Yadukrishnan-KM/Auto_Water_Pump_1HP/Modified Tx unit version using new sensor/Program/AutoWaterPump_Tx_Unit_without_UART_samecode/Microcontroller settings.txt

minicore library(board library)
atmega328p
internal 8 mhz

upload code using ISP method (I used USB ASP Programmer specially for ATMEL), UART not preffered. If crystall is not working then it will fail.
in ISP with or without crystal everything will work.

last update : 16/07/2024
Author : Yadukrishnan K M
