Yadukrishnan-KM/Auto_Water_Pump_1HP/Hardware/Power Circuit/Power Circuit Design report.docx

AC Current Consumption

@228V AC

Idle Condition - 283mA

Relay ON Condition - 372mA
