Yadukrishnan-KM/Auto_Water_Pump_1HP/Hardware/Transmitter/Sensor Unit Design report.docx

Current Measurements of Sensor PCB

@5V

Startup - 13.6mA

Sensor Reading - 16.1mA

Tx active - 15.2mA

Sleep - 4.7mA
