Yadukrishnan-KM/Auto_Water_Pump_1HP/Auto Pump Stickers/front sticker final wrong dimension.png

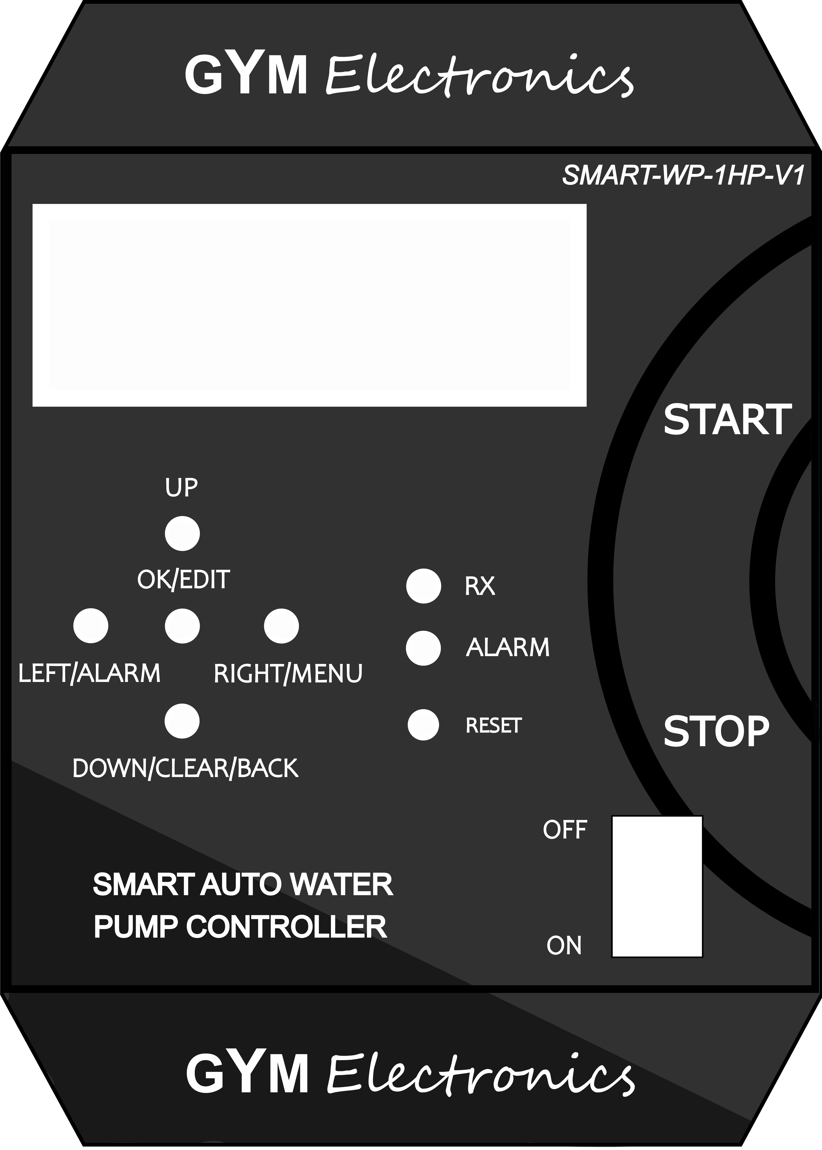
Auto Pump Stickers/front sticker final wrong dimension.png
