Yadukrishnan-KM/Auto_Water_Pump_1HP/Hardware/Datasheet/ATmega328p.png

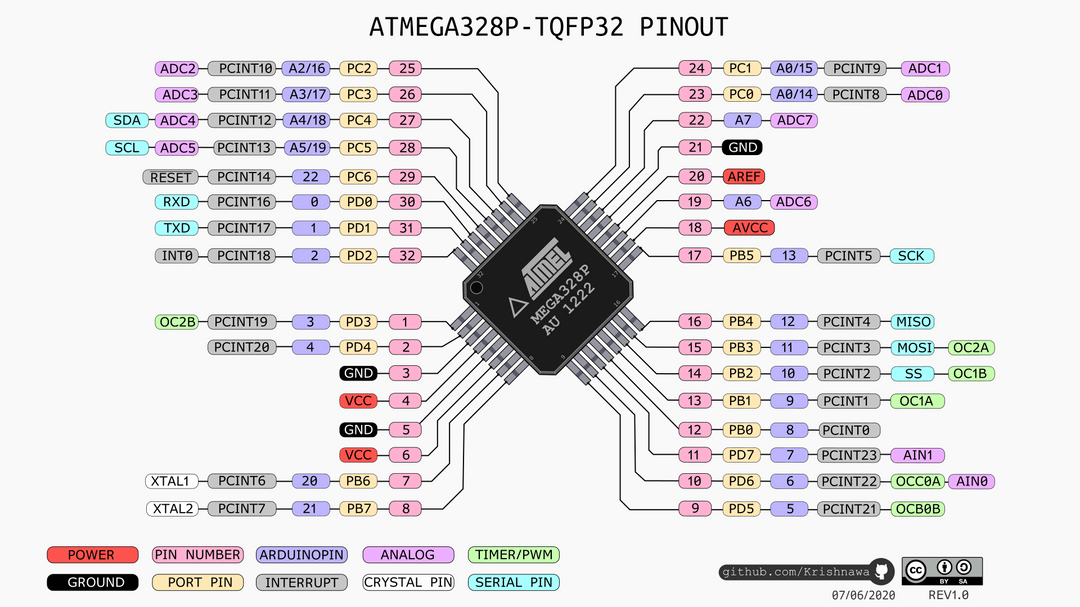
Hardware/Datasheet/ATmega328p.png
