Yadukrishnan-KM/Auto_Water_Pump_1HP/Hardware/Full BOM.xls

Main Controller |  |  |  | Powersupply |  |  |  | Transmitter
ID | Name | Footprint | Quantity | ID | Name | Footprint | Quantity | ID | Name | Footprint | Quantity
Capacitors |  |  |  | Resistors |  |  |  | Capacitors
1 | 100uF | TH CAP-D6.3XF2.5 | 1 | 1 | 435K | R0603 | 1 | 1 | 10uF | C1206 | 4
2 | 10uF | C1206 | 2 | 2 | 220K | R0603 | 3 | 2 | 10uF | C0603 | 2
3 | 10uF | C0805 | 2 | 3 | 100K | R1206 | 2 | 3 | 1uF | C1206 | 1
4 | 0.1uF | C0603 | 9 | 4 | 100K | R0603 | 2 | 4 | 0.1uF | C0603 | 8
5 | 1nF | C0603 | 1 | 5 | 57K | R0603 | 1 | 5 | 1nF | C0603 | 2
6 | 22pF | C0603 | 2 | 6 | 47K | R0603 | 2 | 6 | 10pF | C0603 | 2
Resistors |  |  |  | 7 | 10K | R0603 | 4 | Resistors
1 | 100K | R0603 | 6 | 8 | 3K3 | R0603 | 2 | 1 | 1M | R0603 | 1
2 | 12K | R0603 | 5 | 9 | 3k | R0603 | 1 | 2 | 100K | R0603 | 2
3 | 10K | R0603 | 6 | 10 | 2K2 | R0603 | 3 | 3 | 10K | R0603 | 16
4 | 4.7K | R0603 | 1 | 11 | 1K2 | R0603 | 1 | 4 | 1K | R0603 | 3
5 | 3K3 | R0603 | 1 | 12 | 1k | R0603 | 3 | 5 | 330E | R0603 | 2
6 | 2K | R0603 | 1 | 13 | 220E | R0603 | 1 | Diodes
7 | 1k | R0603 | 7 | 14 | 22E | R1206 | 1 | 1 | SMBJ6.5 | SMB_L4.6-W3.6-LS5.3-BI | 1
8 | 620E | R0603 | 1 | 15 | 1E | R0805 | 3 | 2 | 7V5 | SOD-80_L3.5-W1.5-RD | 1
9 | 330E | R0603 | 1 | 16 | 0E | R1206 | 1 | 3 | LED_SMD | LED0603_RED | 4
10 | 100E | R0603 | 1 | 17 | 0E | R0805 | 4 | Transistors
Transistors |  |  |  | 18 | 1M | R_TH_AXIAL-0.4 | 1 | 1 | 2222A | SOT-23-3 | 7
1 | J3Y | SOT-23-3 | 1 | 19 | 680K | R_TH_AXIAL-0.4 | 1 | 2 | A1SHB | SOT-23 | 2
2 | 2N3904 | SOT-23-3 | 1 | 20 | 1K | R_TH_AXIAL-0.4 | 1 | ICs
3 | 2222A | SOT-23-3 | 5 | 21 | 390E | R_TH_AXIAL-0.3 | 1 | 1 | ATmega328P | TQFP-32 | 1
Diodes |  |  |  | 22 | 220E | TH_RESISTOR_VERTICAL | 1 | 2 | TP4055 | SOT-23-5 | 1
1 | SMBJ6.5C(TVS Diode) | SMB_L4.6-W3.6-LS5.3-BI | 1 | 23 | 120E | R_TH_AXIAL-0.3 | 2 | 3 | HT12E | SOIC20 | 1
2 | LED | LED-TH_BD3.0_BLUE | 2 | 24 | 100E/1W | R_TH_AXIAL-0.5 | 1 | Others
IC's |  |  |  | 25 | 30E | R_TH_AXIAL-0.4 | 1 | 1 | Push Switch SMD | SW-SMD_4P-L5.2-W5.2-P3.70-LS6.4 | 2
1 | ATMEGA328P | TQFP-32 | 1 | 26 | 40000000 | TH_RESISTOR_VERTICAL | 2 | 2 | DIP Switch 8 Pole | SW-TH_1825057-7 | 1
2 | PCF8574T | SOP-16 | 1 | Capacitors |  |  |  | 3 | RF433MHZ Transmitter | RF433MHZ TRANSMITTER MODULE | 1
3 | HT12D | DIP-18 | 1 | 1 | 1000uF | CAP-D8.0×F3.5 | 2 | 4 | 16MHz | SMD 3213 | 1
Others |  |  |  | 2 | 220uF | CAP-D6.3×F2.5 | 2
1 | PushButton | SW-TH_4PIN-L6.00-W6.00 | 6 | 3 | 100uF | CAP-D6.3×F2.5 | 1
2 | 511KD07 | RES-TH_L9.0-W4.6-P5.00-D0.9-S3.4 | 1 | 4 | 100uF | CAP-TH_BD5.0-P2.00-D0.8-FD | 1
3 | 10K | RES-ADJ-TH_3362P | 1 | 5 | 47uF | CAP-TH_BD12.5-P5.00-D0.6-FD | 1
4 | Buzzer | BUZZER-R6.0-2P-7.6MM | 1 | 6 | 47uF/63V | CAP-D5.0×F2.0 | 1
5 | DIP Switch 8 pole | SW-TH_1825057-7 | 1 | 7 | 22uF/63V | CAP-D5.0×F2.0 | 1
6 | Crystal | 16MHZ TH | 1 | 8 | 10uF/63V | CAP-D5.0×F2.0 | 1
7 | AM-RX12A-433 | 433 MHz Radio Receiver Module | 1 | 9 | 4.7uF/63V | CAP-D5.0×F2.0 | 1
Connectors |  |  |  | 10 | 1uF/63V | CAP-D5.0×F2.0 | 1
1 | JST-XH-4-PIN | JST-XH-4PIN-2.5 | 1 | 11 | 470nF | CAP-TH_L17.0-W5.8-P15.00-D0.6 | 1
2 | JST-XH-8-PIN | JST-XH-8PIN-2.5 | 1 | 12 | 330nF | CAP-TH_L18.0-W8.5-P15.00-D1.2 | 1
3 | JST-XH-6-PIN | JST-XH-6PIN-2.5 | 1 | 13 | 150nF | CAP-TH_L18.0-W5.0-P15.00-D1.2 | 2
 |  |  |  | 14 | 100nF | CAP-TH_L8.0-W4.0-P5.00-D1.2 | 1
 |  |  |  | 15 | 100nF | CAP-TH_L18.0-W5.0-P15.00-D1.2 | 2
 |  |  |  | 16 | 68nF | CAP-TH_L10.0-W4.5-P7.50-D1.0 | 1
 |  |  |  | 17 | 47nF | CAP-TH_L9.8-W4.5-P7.50-D0.6 | 1
 |  |  |  | 18 | 1nF | CAP-TH_L7.0-W7.0-P10.00-D1.0 | 1
 |  |  |  | 19 | 10uF | C1206 | 2
 |  |  |  | 20 | 1uF | C0805 | 3
 |  |  |  | 21 | 0.1uF | C0805 | 1
 |  |  |  | 22 | 0.1uF | C0603 | 17
 |  |  |  | ICs
 |  |  |  | 1 | DK112 | DIP-8_L10.0-W6.5-P2.54-LS7.6-BL | 1
 |  |  |  | 2 | LM358 | SOIC-8_L5.0-W4.0-P1.27-LS6.0-BL | 2
 |  |  |  | 3 | TP4056 | SOP-8_EP_150MIL | 1
 |  |  |  | 4 | NE555 | SOP-8_L5.0-W4.0-P1.27-LS6.0-BL | 1
 |  |  |  | 5 | MB10F-10 | MBF_L4.8-W3.9-P2.50-LS6.7-BL | 3
 |  |  |  | 6 | MB10F-12 | MBF_L4.8-W3.9-P2.50-LS6.7-BL | 1
 |  |  |  | 7 | 817C | DIP-4_L6.4-W4.6-P2.54-LS7.6-BL | 5
 |  |  |  | 8 | TPC8107 | SO-8_L4.9-W3.9-P1.27-LS5.9-BL | 1
 |  |  |  | 9 | TL431 | TO-92-3_L4.9-W3.7-P2.54-L | 3
 |  |  |  | Transitors
 |  |  |  | 1 | BC846 | SOT-323-3_L2.0-W1.3-P1.30-LS2.1-BR | 1
 |  |  |  | 2 | BT2907 | SOT-323-3_L2.0-W1.3-P1.30-LS2.1-BR | 1
 |  |  |  | 3 | 2SD882T-P | SOT-89-3_L4.5-W2.5-P1.50-LS4.2-BR | 1
 |  |  |  | Diodes
 |  |  |  | 1 | SS24 | SMA_L4.3-W2.6-LS5.2-RD | 2
 |  |  |  | 2 | 1N5819 | SOD-123FL_L2.7-W1.8-LS3.8-RD | 1
 |  |  |  | 3 | ES1M | DO-214AC_L4.3-W2.7-LS5.3-FD | 2
 |  |  |  | 4 | SS26 | SMA_L4.3-W2.6-LS5.2-RD | 2
 |  |  |  | 5 | RS1MG | SMA_L4.3-W2.6-LS5.2-RD | 2
 |  |  |  | 6 | F7-DF | SOD-123FL_L2.6-W1.6-LS3.4-R-FD | 2
 |  |  |  | 7 | 8V2 | ZENER UP | 2
 |  |  |  | 8 | 5V1 | ZENER UP | 1
 |  |  |  | 9 | 6V2 | ZENER UP | 1
 |  |  |  | 10 | LED TH | LED-TH_BD3.0_GREEN | 5
 |  |  |  | 11 | LED SMD | 0603 | 2
 |  |  |  | Others
 |  |  |  | 1 | 511KD07 | RES-TH_L9.0-W4.6-P5.00-D0.9-S3.4 | 1
 |  |  |  | 2 | TVR14471KSY | RES-TH_L15.5-W5.8-P7.50-D1.2-S2.10 | 1
 |  |  |  | 3 | TVR10561KSY | RES-TH_L12.5-W5.9-P7.50-D0.8-S3.00 | 2
 |  |  |  | 4 | NTC | RES-TH_L10.5-W5.5-P7.50-D0.6-S5.50 | 1
 |  |  |  | 5 | 10K Mutiturn Preset | RES-ADJ-TH_3P-L9.5-W4.9-P2.50-L_3296W | 4
 |  |  |  | 6 | SMPS Transformer | EE2520 | 1
 |  |  |  | 7 | Filter_FL2D-10-222 | FILTER-TH_4P-L17.0-W9.6-P5.00-LS4.5-BL | 1
 |  |  |  | 8 | Inductor | TH_FASTRON_07HCP_INDUCTOR | 1
 |  |  |  | 9 | Current Transformer | CT_PCB_TH | 1
 |  |  |  | 10 | Fuse clip | FUSE-TH_5X20RHOSFUSECLIP-SEAT | 2
 |  |  |  | Connectors
 |  |  |  | 1 | JST_2_Pole | JST-XH-02-PACKAGE-LONG-PAD-2.5MMPITCH | 3
 |  |  |  | 2 | JST_6_Pole | CONN-TH_6P-P2.00_FWF20001-S06S22W1B | 1
