Yadukrishnan-KM/Auto_Water_Pump_1HP/Hardware/Main Controller/BOM_Auto-water-pump_Main-board_2024-04-29.xls

 | ID | Name | Footprint | Quantity
 | Capacitors |  |  |  | 1
2 | 1 | 100uF | TH CAP-D6.3XF2.5 | 1
3 | 2 | 10uF | C1206 | 2
4 | 3 | 10uF | C0805 | 2
5 | 4 | 0.1uF | C0603 | 9
6 | 5 | 1nF | C0603 | 1
7 | 6 | 22pF | C0603 | 2
8 | Resistors
11 | 1 | 100K | R0603 | 6
12 | 2 | 12K | R0603 | 5
13 | 3 | 10K | R0603 | 6
14 | 4 | 4.7K | R0603 | 1
15 | 5 | 3K3 | R0603 | 1
16 | 6 | 2K | R0603 | 1
17 | 7 | 1k | R0603 | 7
18 | 8 | 620E | R0603 | 1
19 | 9 | 330E | R0603 | 1
20 | 10 | 100E | R0603 | 1
21 | Transistors
24 | 1 | J3Y | SOT-23-3 | 1
25 | 2 | 2N3904 | SOT-23-3 | 1
26 | 3 | 2222A | SOT-23-3 | 5
27 | Diodes
30 | 1 | SMBJ6.5C(TVS Diode) | SMB_L4.6-W3.6-LS5.3-BI | 1
31 | 2 | LED | LED-TH_BD3.0_BLUE | 2
32 | IC's
33 | 1 | ATMEGA328P | TQFP-32 | 1
34 | 2 | PCF8574T | SOP-16 | 1
35 | 3 | HT12D | DIP-18 | 1
36 | Others
37 | 1 | PushButton | SW-TH_4PIN-L6.00-W6.00 | 6
38 | 2 | 511KD07 | RES-TH_L9.0-W4.6-P5.00-D0.9-S3.4 | 1
39 | 3 | 10K | RES-ADJ-TH_3362P | 1
40 | 4 | Buzzer | BUZZER-R6.0-2P-7.6MM | 1
41 | 5 | DIP Switch 8 pole | SW-TH_1825057-7 | 1
42 | 6 | Crystal | 16MHZ TH | 1
43 | 7 | AM-RX12A-433 | 433 MHz Radio Receiver Module | 1
44 | Connectors
45 | 1 | JST-XH-4-PIN | JST-XH-4PIN-2.5 | 1
46 | 2 | JST-XH-8-PIN | JST-XH-8PIN-2.5 | 1
47 | 3 | JST-XH-6-PIN | JST-XH-6PIN-2.5 | 1
48
49
50
51
52
53
54
55
56
57
58
59
