Yadukrishnan-KM/Auto_Water_Pump_1HP/Hardware/Power Circuit/BOM_Auto-water-pump_power-circuit_2024-04-29.xls

 | ID | Name | Footprint | Quantity
 | Resistors
1 | 1 | 435K | R0603 | 1
2 | 2 | 220K | R0603 | 3
3 | 3 | 100K | R1206 | 2
4 | 4 | 100K | R0603 | 2
5 | 5 | 57K | R0603 | 1
6 | 6 | 47K | R0603 | 2
7 | 7 | 10K | R0603 | 4
8 | 8 | 3K3 | R0603 | 2
9 | 9 | 3k | R0603 | 1
10 | 10 | 2K2 | R0603 | 3
11 | 11 | 1K2 | R0603 | 1
12 | 12 | 1k | R0603 | 3
13 | 13 | 220E | R0603 | 1
14 | 14 | 22E | R1206 | 1
15 | 15 | 1E | R0805 | 3
16 | 16 | 0E | R1206 | 1
17 | 17 | 0E | R0805 | 4
18 | 18 | 1M | R_TH_AXIAL-0.4 | 1
19 | 19 | 680K | R_TH_AXIAL-0.4 | 1
20 | 20 | 1K | R_TH_AXIAL-0.4 | 1
21 | 21 | 390E | R_TH_AXIAL-0.3 | 1
22 | 22 | 220E | TH_RESISTOR_VERTICAL | 1
23 | 23 | 120E | R_TH_AXIAL-0.3 | 2
24 | 24 | 100E/1W | R_TH_AXIAL-0.5 | 1
 | 25 | 30E | R_TH_AXIAL-0.4 | 1
25 | 26 | 40000000 | TH_RESISTOR_VERTICAL | 2
26 | Capacitors
27 | 1 | 1000uF | CAP-D8.0×F3.5 | 2
28 | 2 | 220uF | CAP-D6.3×F2.5 | 2
29 | 3 | 100uF | CAP-D6.3×F2.5 | 1
30 | 4 | 100uF | CAP-TH_BD5.0-P2.00-D0.8-FD | 1
31 | 5 | 47uF | CAP-TH_BD12.5-P5.00-D0.6-FD | 1
32 | 6 | 47uF/63V | CAP-D5.0×F2.0 | 1
33 | 7 | 22uF/63V | CAP-D5.0×F2.0 | 1
34 | 8 | 10uF/63V | CAP-D5.0×F2.0 | 1
35 | 9 | 4.7uF/63V | CAP-D5.0×F2.0 | 1
36 | 10 | 1uF/63V | CAP-D5.0×F2.0 | 1
37 | 11 | 470nF | CAP-TH_L17.0-W5.8-P15.00-D0.6 | 1
38 | 12 | 330nF | CAP-TH_L18.0-W8.5-P15.00-D1.2 | 1
39 | 13 | 150nF | CAP-TH_L18.0-W5.0-P15.00-D1.2 | 2
40 | 14 | 100nF | CAP-TH_L8.0-W4.0-P5.00-D1.2 | 1
41 | 15 | 100nF | CAP-TH_L18.0-W5.0-P15.00-D1.2 | 2
42 | 16 | 68nF | CAP-TH_L10.0-W4.5-P7.50-D1.0 | 1
43 | 17 | 47nF | CAP-TH_L9.8-W4.5-P7.50-D0.6 | 1
44 | 18 | 1nF | CAP-TH_L7.0-W7.0-P10.00-D1.0 | 1
45 | 19 | 10uF | C1206 | 2
46 | 20 | 1uF | C0805 | 3
47 | 21 | 0.1uF | C0805 | 1
48 | 22 | 0.1uF | C0603 | 17
49 | ICs
50 | 1 | DK112 | DIP-8_L10.0-W6.5-P2.54-LS7.6-BL | 1
51 | 2 | LM358 | SOIC-8_L5.0-W4.0-P1.27-LS6.0-BL | 2
52 | 3 | TP4056 | SOP-8_EP_150MIL | 1
53 | 4 | NE555 | SOP-8_L5.0-W4.0-P1.27-LS6.0-BL | 1
54 | 5 | MB10F-10 | MBF_L4.8-W3.9-P2.50-LS6.7-BL | 3
55 | 6 | MB10F-12 | MBF_L4.8-W3.9-P2.50-LS6.7-BL | 1
56 | 7 | 817C | DIP-4_L6.4-W4.6-P2.54-LS7.6-BL | 5
57 | 8 | TPC8107 | SO-8_L4.9-W3.9-P1.27-LS5.9-BL | 1
58 | 9 | TL431 | TO-92-3_L4.9-W3.7-P2.54-L | 3
59 | Transitors
60 | 1 | BC846 | SOT-323-3_L2.0-W1.3-P1.30-LS2.1-BR | 1
61 | 2 | BT2907 | SOT-323-3_L2.0-W1.3-P1.30-LS2.1-BR | 1
62 | 3 | 2SD882T-P | SOT-89-3_L4.5-W2.5-P1.50-LS4.2-BR | 1
63 | Diodes
64 | 1 | SS24 | SMA_L4.3-W2.6-LS5.2-RD | 2
65 | 2 | 1N5819 | SOD-123FL_L2.7-W1.8-LS3.8-RD | 1
66 | 3 | ES1M | DO-214AC_L4.3-W2.7-LS5.3-FD | 2
67 | 4 | SS26 | SMA_L4.3-W2.6-LS5.2-RD | 2
68 | 5 | RS1MG | SMA_L4.3-W2.6-LS5.2-RD | 2
69 | 6 | F7-DF | SOD-123FL_L2.6-W1.6-LS3.4-R-FD | 2
70 | 7 | 8V2 | ZENER UP | 2
71 | 8 | 5V1 | ZENER UP | 1
72 | 9 | 6V2 | ZENER UP | 1
73 | 10 | LED TH | LED-TH_BD3.0_GREEN | 5
74 | 11 | LED SMD | 0603 | 2
75 | Others
76 | 1 | 511KD07 | RES-TH_L9.0-W4.6-P5.00-D0.9-S3.4 | 1
77 | 2 | TVR14471KSY | RES-TH_L15.5-W5.8-P7.50-D1.2-S2.10 | 1
78 | 3 | TVR10561KSY | RES-TH_L12.5-W5.9-P7.50-D0.8-S3.00 | 2
79 | 4 | NTC | RES-TH_L10.5-W5.5-P7.50-D0.6-S5.50 | 1
80 | 5 | 10K Mutiturn Preset | RES-ADJ-TH_3P-L9.5-W4.9-P2.50-L_3296W | 4
81 | 6 | SMPS Transformer | EE2520 | 1
82 | 7 | Filter_FL2D-10-222 | FILTER-TH_4P-L17.0-W9.6-P5.00-LS4.5-BL | 1
83 | 8 | Inductor | TH_FASTRON_07HCP_INDUCTOR | 1
84 | 9 | Current Transformer | CT_PCB_TH | 1
85 | 10 | Fuse clip | FUSE-TH_5X20RHOSFUSECLIP-SEAT | 2
86 | Connectors
87 | 1 | JST_2_Pole | JST-XH-02-PACKAGE-LONG-PAD-2.5MMPITCH | 3
88 | 2 | JST_6_Pole | CONN-TH_6P-P2.00_FWF20001-S06S22W1B | 1
