Yadukrishnan-KM/Auto_Water_Pump_1HP/Hardware/Transmitter/BOM_Auto-water-pump_Sensor_RemoteBoard_2024-04-29.xls

 | ID | Name | Footprint | Quantity
1 | Capacitors
2 | 1 | 10uF | C1206 | 4
3 | 2 | 10uF | C0603 | 2
4 | 3 | 1uF | C1206 | 1
5 | 4 | 0.1uF | C0603 | 8
6 | 5 | 1nF | C0603 | 2
7 | 6 | 10pF | C0603 | 2
8 | Resistors
9 | 1 | 1M | R0603 | 1
10 | 2 | 100K | R0603 | 2
11 | 3 | 10K | R0603 | 16
12 | 4 | 1K | R0603 | 3
13 | 5 | 330E | R0603 | 2
14 | Diodes
15 | 1 | SMBJ6.5 | SMB_L4.6-W3.6-LS5.3-BI | 1
16 | 2 | 7V5 | SOD-80_L3.5-W1.5-RD | 1
17 | 3 | LED_SMD | LED0603_RED | 4
18 | Transistors
19 | 1 | 2222A | SOT-23-3 | 7
20 | 2 | A1SHB | SOT-23 | 2
21 | ICs
22 | 1 | ATmega328P | TQFP-32 | 1
23 | 2 | TP4055 | SOT-23-5 | 1
24 | 3 | HT12E | SOIC20 | 1
25 | Others
26 | 1 | Push Switch SMD | SW-SMD_4P-L5.2-W5.2-P3.70-LS6.4 | 2
27 | 2 | DIP Switch 8 Pole | SW-TH_1825057-7 | 1
28 | 3 | RF433MHZ Transmitter | RF433MHZ TRANSMITTER MODULE | 1
29 | 4 | 16MHz | SMD 3213 | 1
