Yadukrishnan-KM/Auto_Water_Pump_1HP/Hardware/Modification Required/Other two PCB Modification Rrequired.xls

COMPONENT | COMPONENT ID | DEFECT | CORRECTIOM REQUIRED | PCB
Rx, Tx output pins on both PCB |  | Silkscreen marking interchanged(actual prblm in circuit net labelling) | Need to interchange it back Rx to Tx and TX to RX | Both
filter capacitor 10uF in transmitter |  | microcontroller getting restart when corresponding mosfet getting on | remove both 10uf | Transmitter
pulldown resistor for on/off button motor |  | no pulldown resistor for both on and off push button | add pulldown resistor of 10k | Main controller
resistors for navigation button resistor network 1K, 3K | R8, R6 | silkscreen wrong interchanged | interchange resistor silkscreen | Main controller
ADC0 23 pin |  | circuit and pcb updation | connect solar chage pin of chager ic to ADC0 of atmega328 pin 23 | Transmitter
crystal (dont remove just keep) | TXAL1 | atmega 328 getting restart and getting freeze while working from battery in 16MHz external | use internal 8MHz clock by using minicore board manager | Transmitter
ISP Header |  | No ISP header | Add ISP Header for programing | Main controller
