Yadukrishnan-KM/Auto_Water_Pump_1HP/Hardware/Modification Required/Power PCB Modification Rrequired.xls

COMPONENT | COMPONENT ID | DEFECT | CORRECTIOM REQUIRED
Batt Connector | CN3 | footprint. pitch 2 mm | pitch 2.54mm, take 5v output connector footprint
Batt Connector, 5V output | CN3, X1 | silkscreen interchanged | change silkscreen name print in opposite, 5v to batt and batt to 5v
smps Transformer | T2 | drill hole too big | reduce drill hole dia
Main filter Cap 47 uf | C22 | drill hole too big | reduce drill hole dia
fuse base | U1, U2 | drill hole too big | reduce drill hole dia, like capacitor holes
68nF AC cap | U4 | foot print 7.5mm | footprint leg to leg required 10mm
Input choke filter inductor | L2 | foot print small length btween legs | foot print as required
12v relay connector hole | X2 | drill hole little small | drill hole 0.8mm
6V2 zener | ZD3 | drill hole little small | drill hole 0.8mm
PCB LED TH | LED1,2,3,5 | silkscreen no polarity | silkscreen polarity required
SMPS bridge rectifier | D6 | wrong component | need to change to DB107S
MAIN SMPS output divider | R26,27 | wrong value | need to find correct value
All ES1M |  | wrong component | chane to RS1M
12v relay circuit |  | circuit update | need to give option for taking 12v as well as 24v by using jumpers
Cap and resitor for power available optocoupler | C5, R6 | silkscreen interchanged | change silkscreen name print in opposite, cap to resistor and res to cap
Wrong Connection, circuit error | LED5, R44 | LED is glowing when relay off, gpoing off when relay get powered | modify the circuit by putting led parallel to relay output port
relay indicator led resistor | R44 | wrong value | change to 4.7K
battery backup circuit | D16 | direct powering from battery making LCD dim and not readable | add 5V boost circuit while AC not available in the place of using just one diode
backup diode | D16 | if not doing the 5v boost converter, this diode making more drop us1M, rs1M -.48 drop. but ss24,ss26 only .1v drop | if not using 5v boost use SS26 diode
new resistor |  | D14 diode leakage current making charging led bright | use 10K resistor parallel to charging led
test points | R38,R42, R15, R16 | no test points in toplayer | give test points for all the multiturn pot in top layer
battery on off switch |  | absence of battery on/off switch | add power switch for battery power
