Yadukrishnan-KM/Auto_Water_Pump_1HP/Hardware/Power Circuit/Schematic_Auto-water-pump_power-circuit_2024-04-29-1.pdf

Ac Input Circuit | AC Sensing Circuit

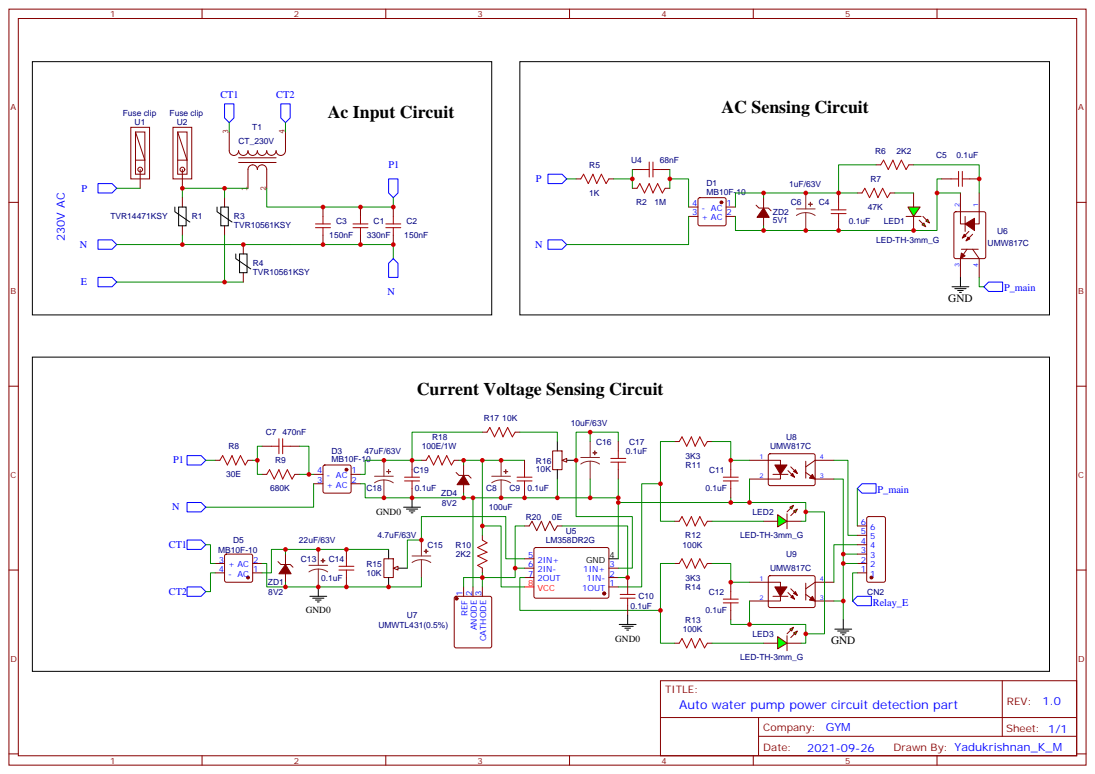
[picture p3: page 1]

Current Voltage Sensing Circuit

230V SMPS - 5V,12V | Relay Control Circuit

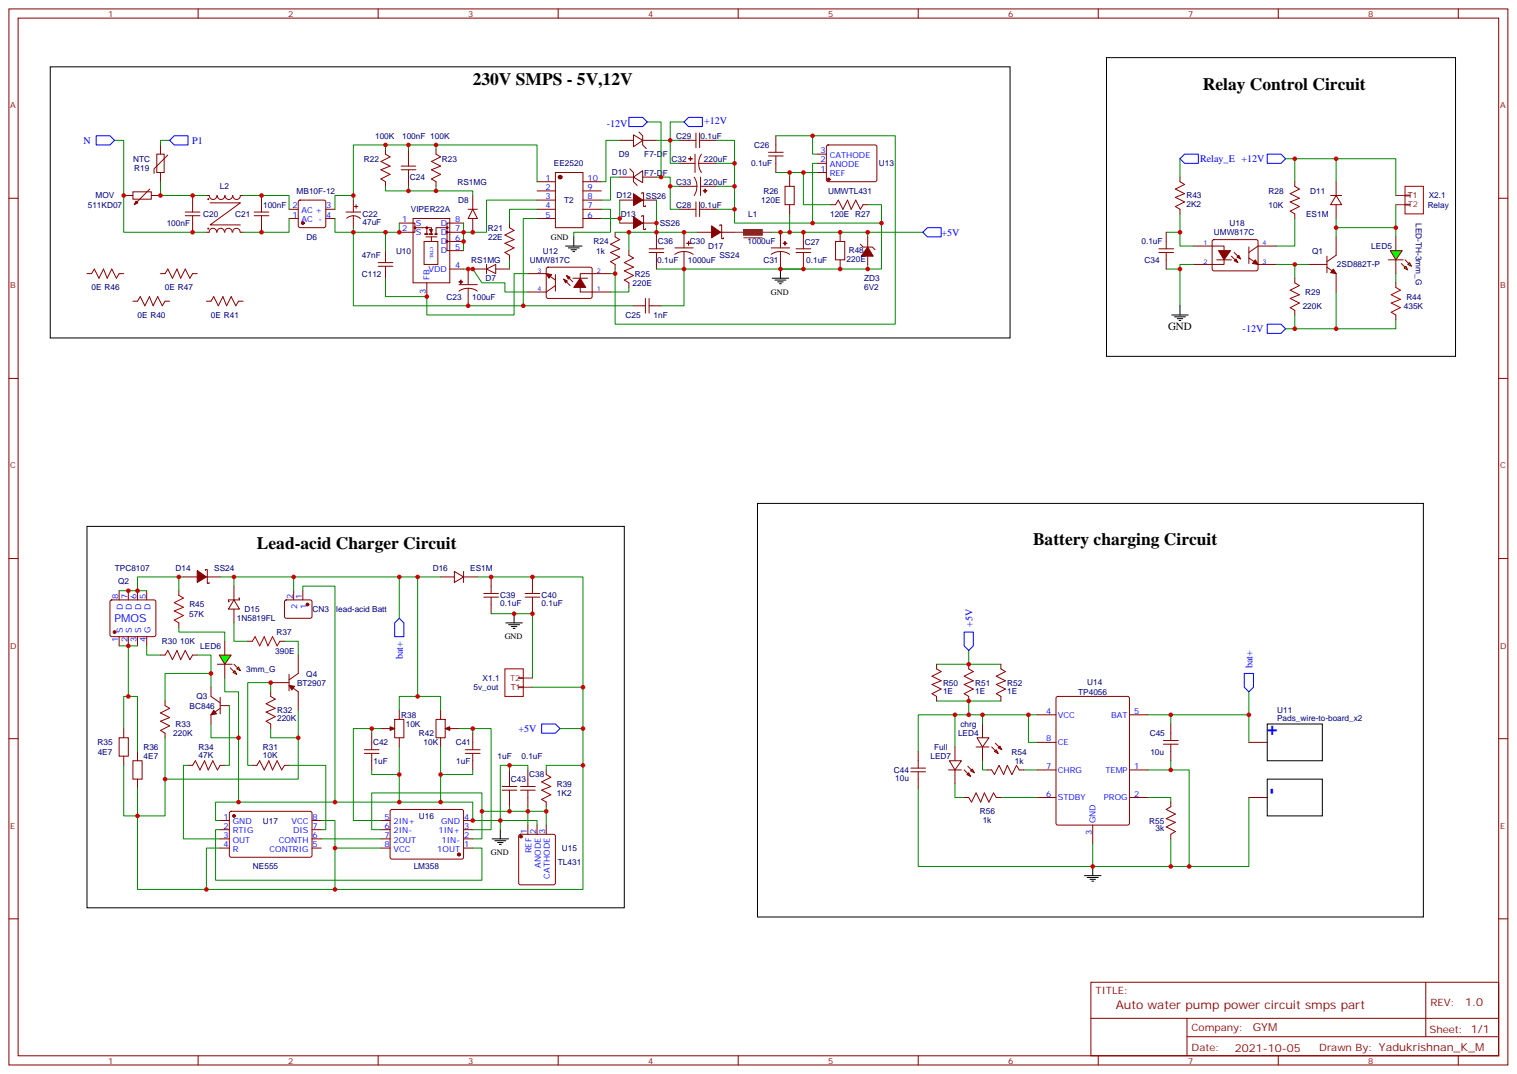
[picture p4: page 2]

Lead-acid Charger Circuit
