Yadukrishnan-KM/Auto_Water_Pump_1HP/Auto Pump Stickers/Auto pump Full sticker final edit option.pdf

## INPUT ~230V

## OUTPUT ~230V / 1 HP

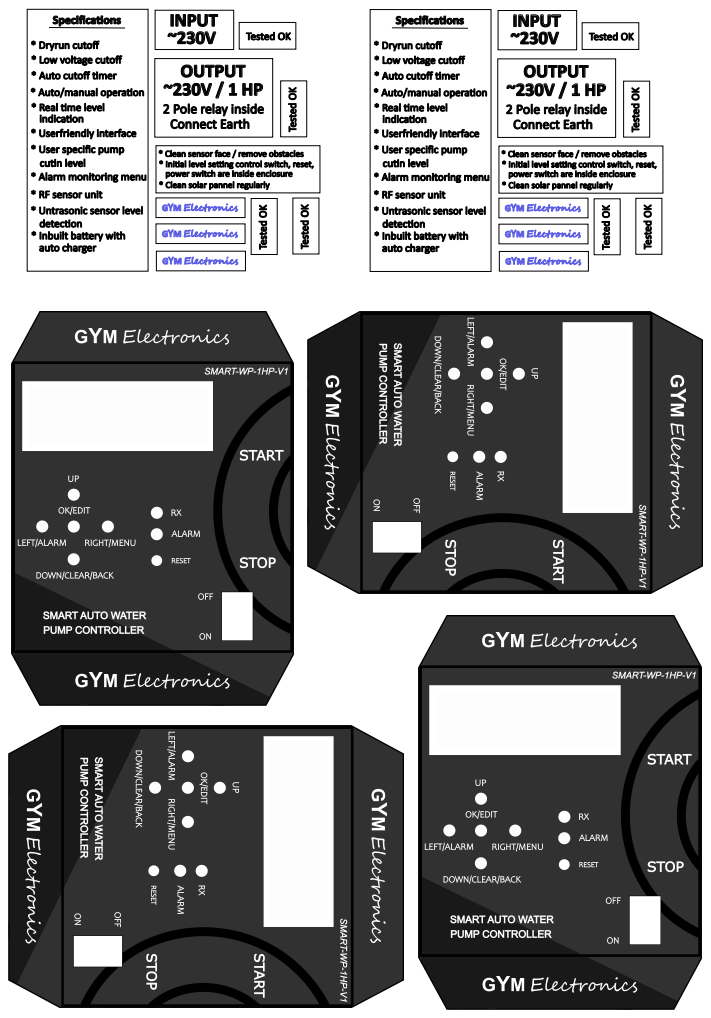
[picture p5: page 1]
Specificaons; Connect Earth; Teste; Tested OK; INPUT ~230V; OUTPUT ~230V / 1 HP

* Dryrun cutoff
* Low voltage cutoff
* Auto cutoff mer
* Auto/manual operaon
* Real me level
indicaon
* Userfriendly interface
* User specific pump
cun level
* Alarm monitoring menu
* RF sensor unit
* Untrasonic sensor level
detecon
* Inbuilt baery with
auto charger

2 Pole relay inside

* Clean sensor face / remove obstacles
* Inial level seng control switch, reset,
power switch are inside enclosure
* Clean solar pannel regularly
GYM Eecric
