Yadukrishnan-KM/Auto_Water_Pump_1HP/Hardware/Main Controller/Schematic_Auto-water-pump_Main-board_2024-04-29.pdf

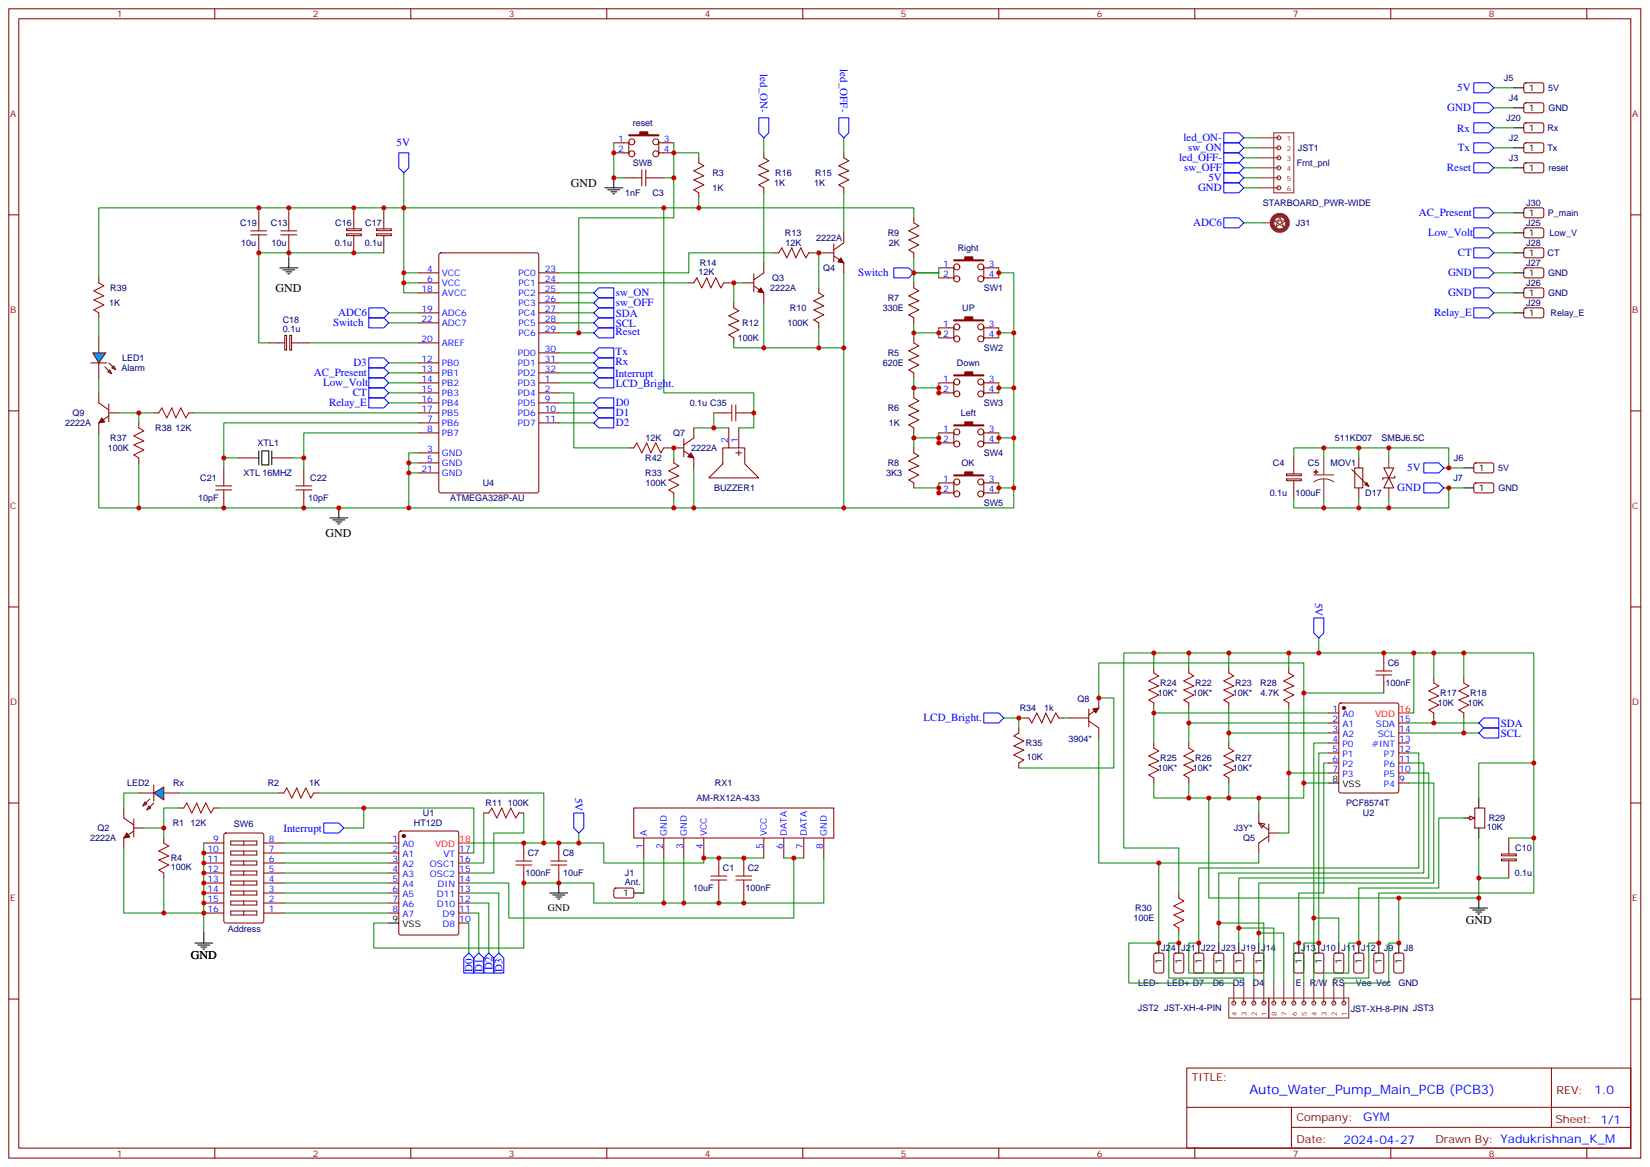
[picture p6: page 1]
