Yadukrishnan-KM/Auto_Water_Pump_1HP/Hardware/Transmitter/Schematic_Auto-water-pump_Sensor_RemoteBoard_2024-04-29.pdf

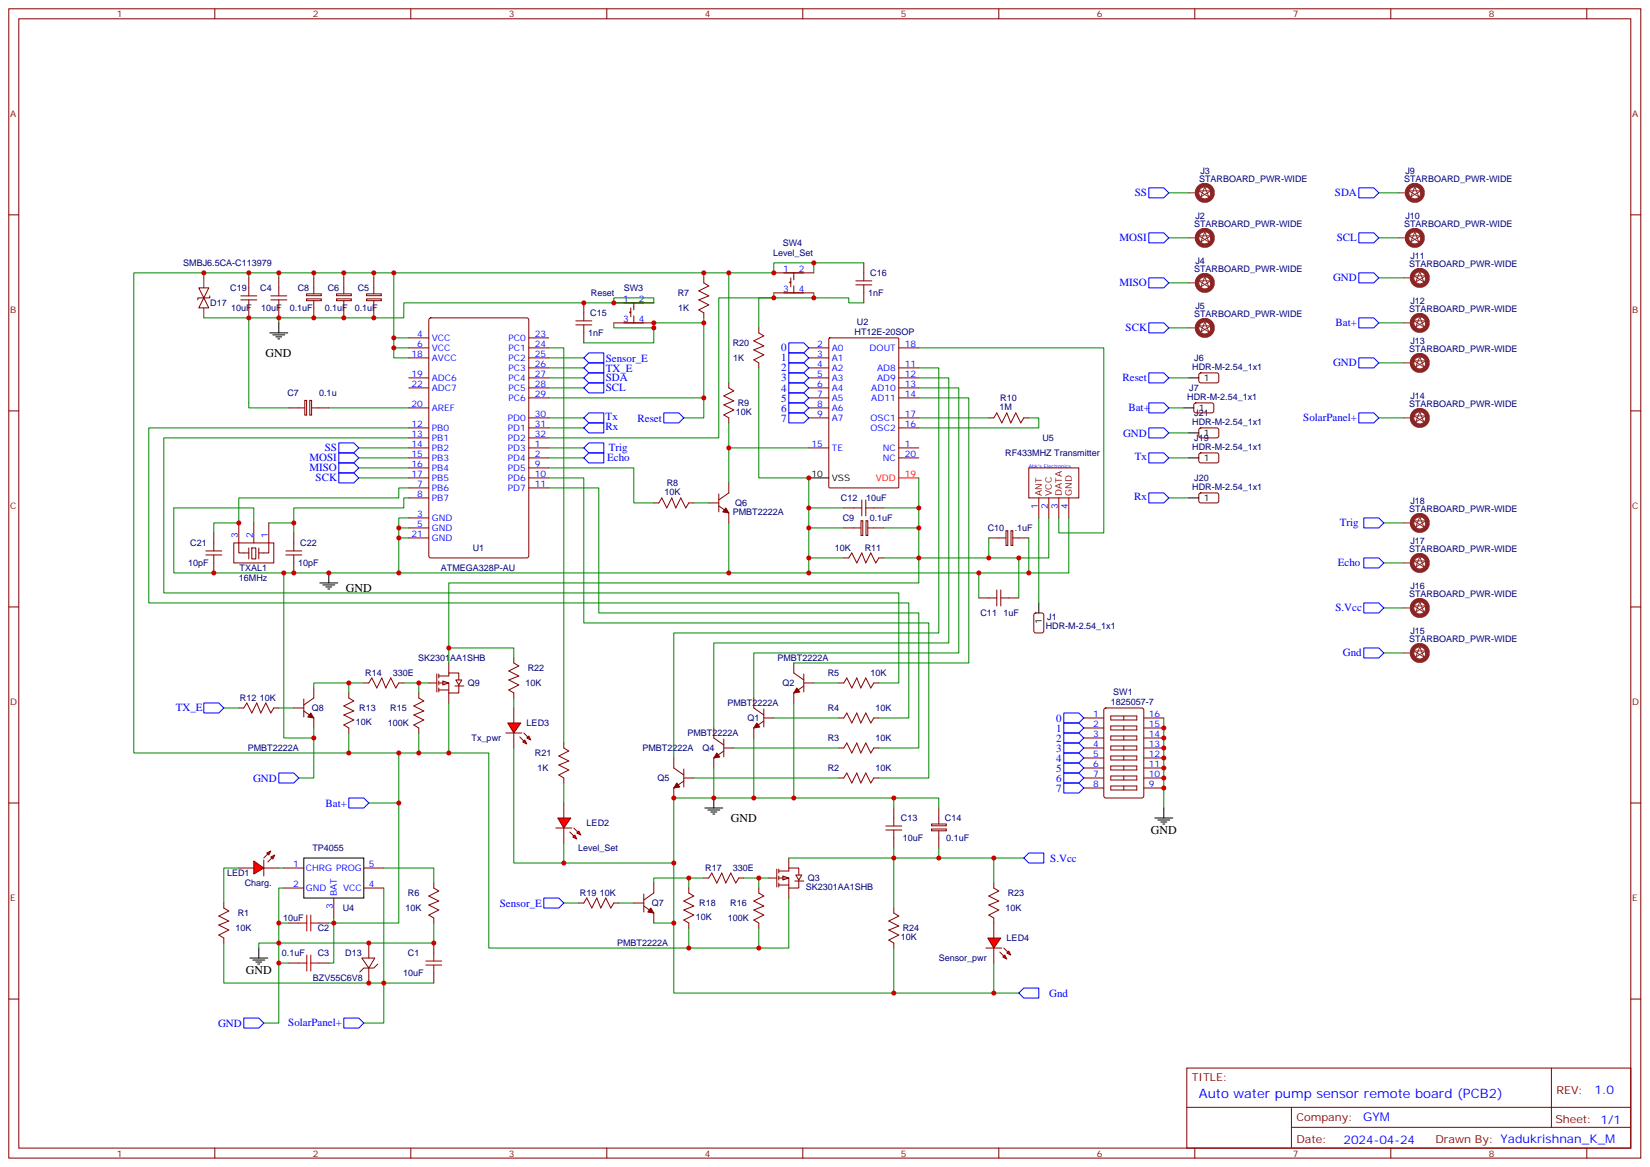
[picture p7: page 1]
