Yadukrishnan-KM/Auto_Water_Pump_1HP/(commit log)

2025-02-22 Initial commit_Tx unit code contain sensor testing codes
2025-02-22 Adding previous files which contain all the past project details
    [BOM_Auto-water-pump_Main-board_2024-04-29.xls, BOM_Auto-water-pump_Sensor_RemoteBoard_2024-04-29.xls, BOM_Auto-water-pump_power-circuit_2024-04-29.xls, Full BOM.xls, Other two PCB Modification Rrequired.xls, Power PCB Modification Rrequired.xls]
2025-03-08 New sensor DYPA02YYUW code added into the main code and successfully compiled
2025-06-06 Added new senspor code, new sleep code and sleep time code for saving power
